fsanzeni/FSC-BT631D-Breakout/ADAU1701-DSP/ADAU1701-DSP.kicad_pcb

## KiCad design ADAU1701-DSP/ADAU1701-DSP.kicad_pcb (2025-05-22)

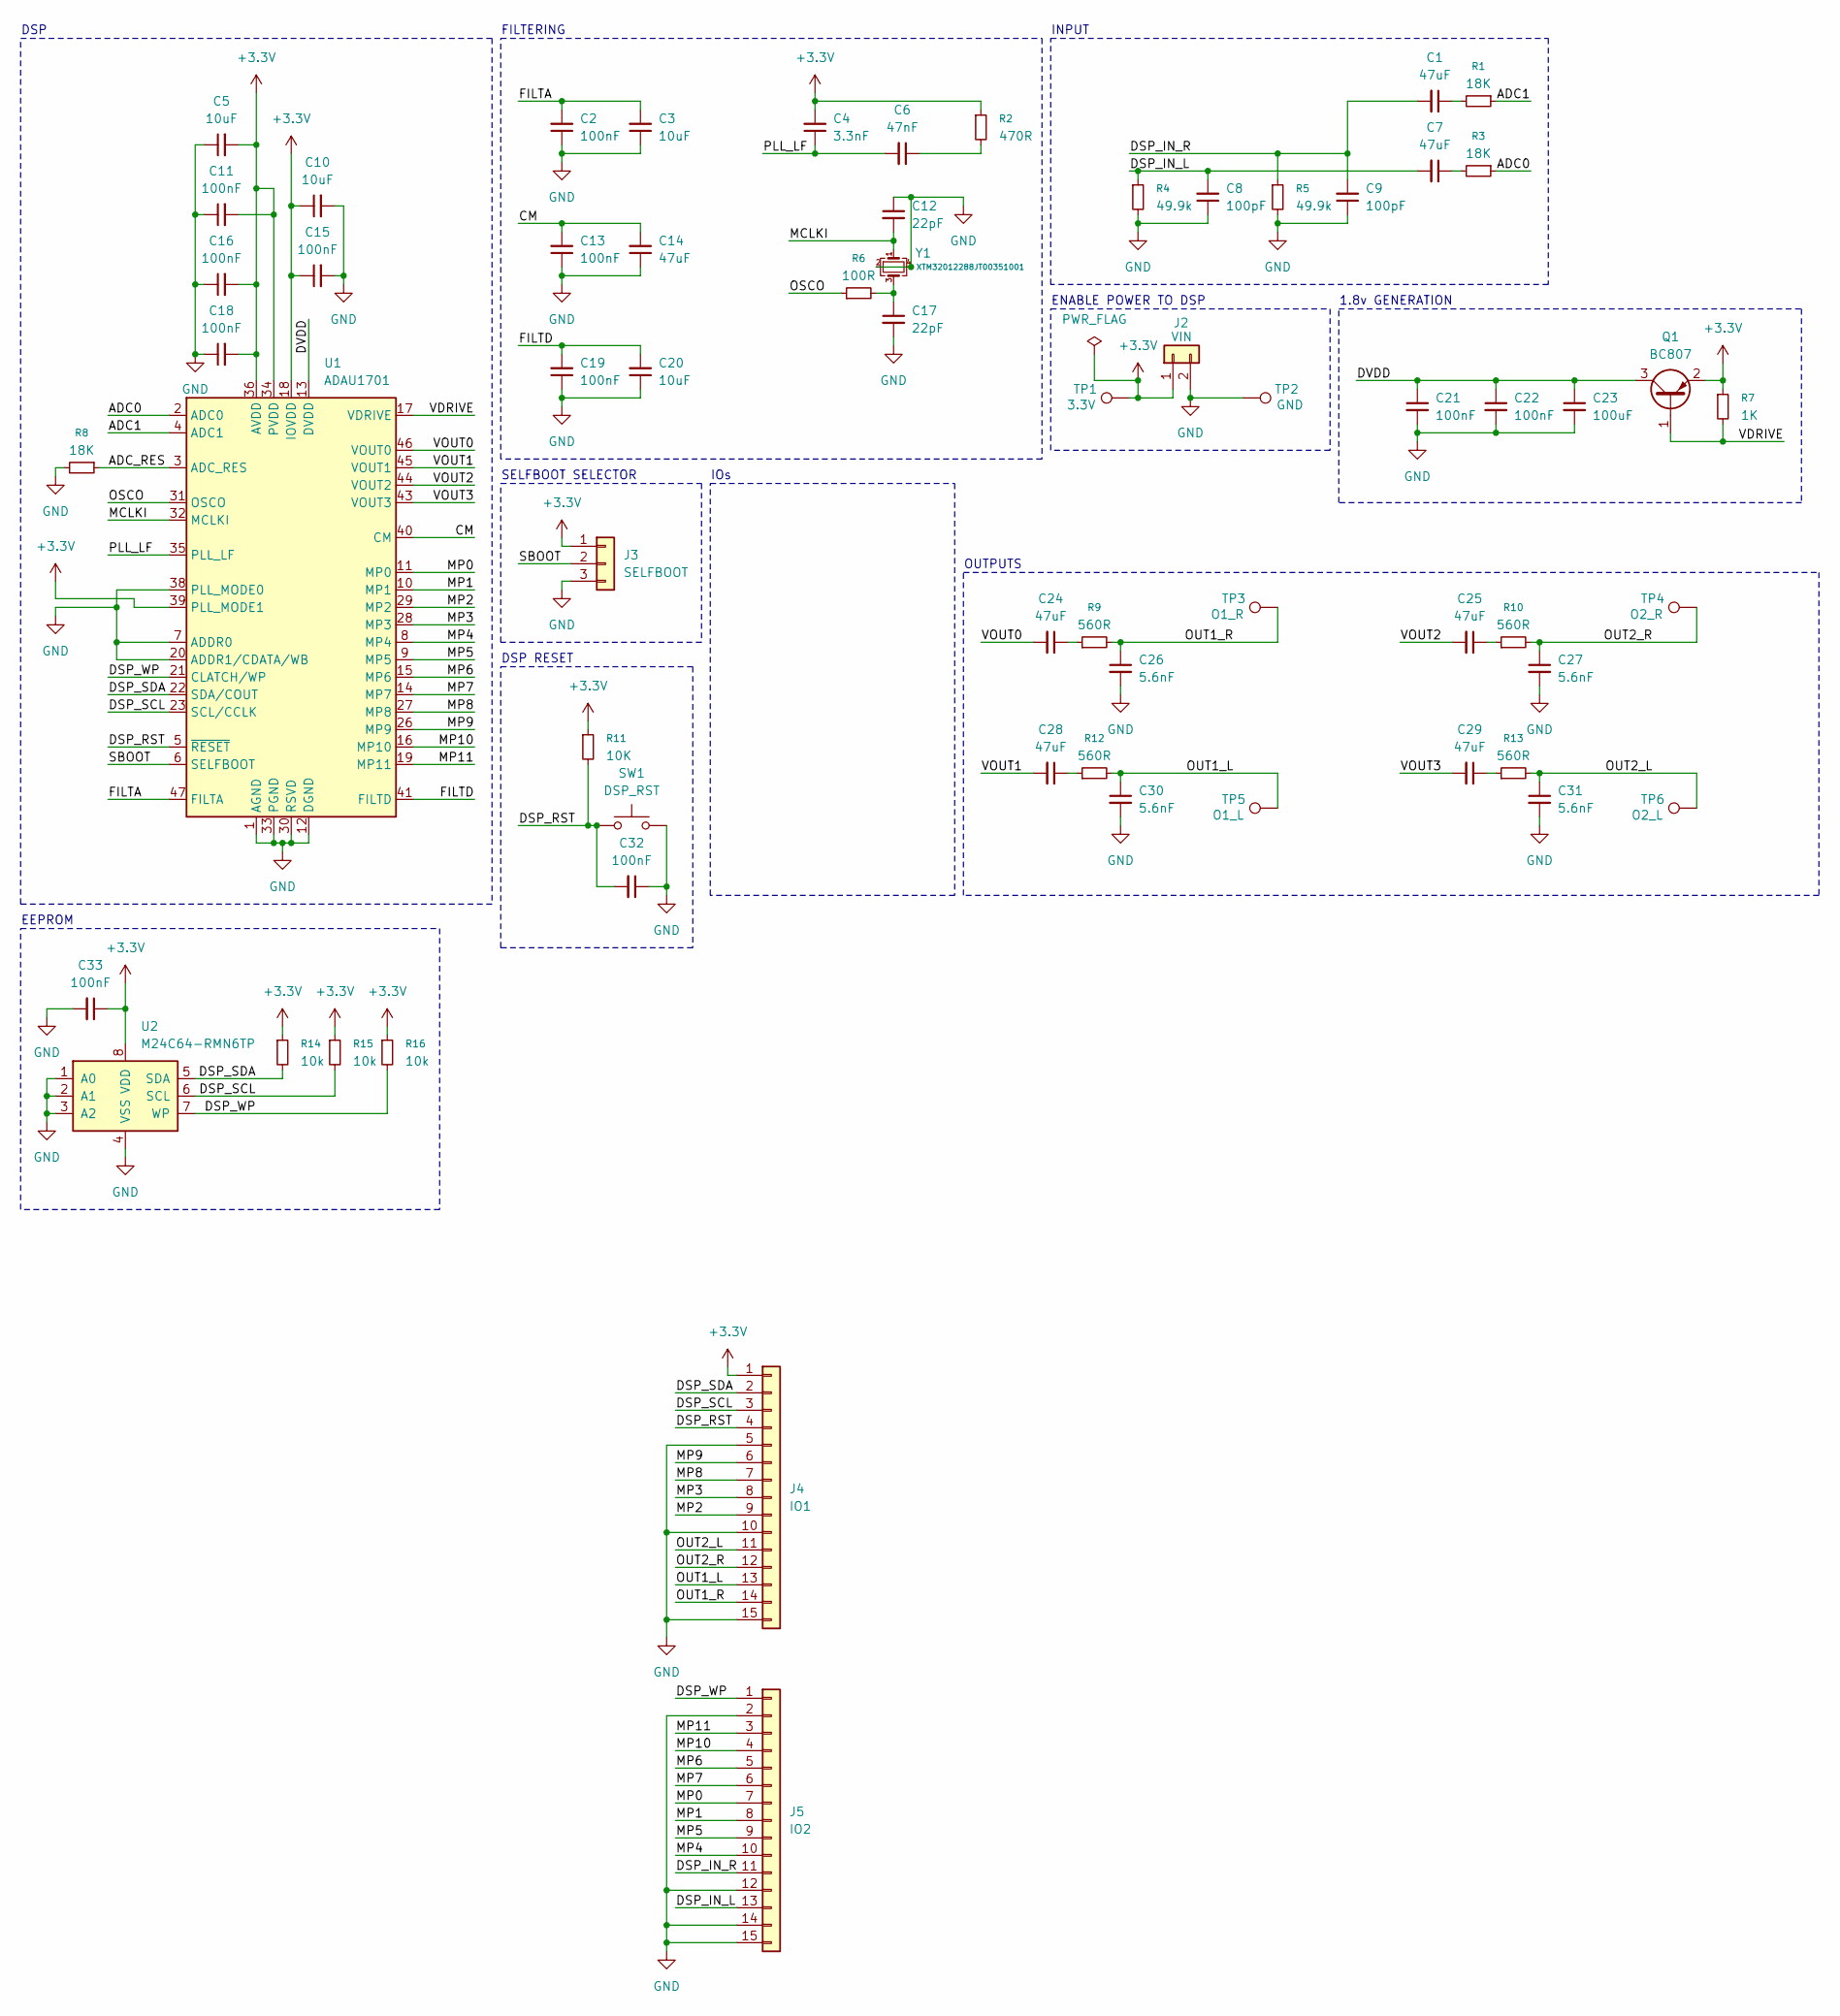
[picture p1: schematic ADAU1701-DSP.kicad_sch]

Parts:
C1, C7, C14, C24, C25, C28, C29: 47uF; C_0603_1608Metric_Pad1.08x0.95mm_HandSolder
C2, C11, C13, C15, C16, C18, C19, C21, C22, C32, C33: 100nF; C_0603_1608Metric_Pad1.08x0.95mm_HandSolder
C3, C5, C10, C20: 10uF; C_0603_1608Metric_Pad1.08x0.95mm_HandSolder
C4: 3.3nF; C_0603_1608Metric_Pad1.08x0.95mm_HandSolder
C6: 47nF; C_0603_1608Metric_Pad1.08x0.95mm_HandSolder
C8, C9: 100pF; C_0603_1608Metric_Pad1.08x0.95mm_HandSolder
C12, C17: 22pF; C_0603_1608Metric_Pad1.08x0.95mm_HandSolder
C23: 100uF; C_0603_1608Metric_Pad1.08x0.95mm_HandSolder
C26, C27, C30, C31: 5.6nF; C_0603_1608Metric_Pad1.08x0.95mm_HandSolder
J2: VIN; PinSocket_1x02_P2.54mm_Vertical
J3: SELFBOOT; PinHeader_1x03_P2.54mm_Vertical
J4: IO1; PinSocket_1x15_P2.54mm_Vertical
J5: IO2; PinSocket_1x15_P2.54mm_Vertical
Q1: BC807; SOT-23
R1, R3, R8: 18K; R_0603_1608Metric_Pad0.98x0.95mm_HandSolder
R2: 470R; R_0603_1608Metric_Pad0.98x0.95mm_HandSolder
R4, R5: 49.9k; R_0603_1608Metric_Pad0.98x0.95mm_HandSolder
R6: 100R; R_0603_1608Metric_Pad0.98x0.95mm_HandSolder
R7: 1K; R_0603_1608Metric_Pad0.98x0.95mm_HandSolder
R9, R10, R12, R13: 560R; R_0603_1608Metric_Pad0.98x0.95mm_HandSolder
R11: 10K; R_0603_1608Metric_Pad0.98x0.95mm_HandSolder
R14, R15, R16: 10k; R_0603_1608Metric_Pad0.98x0.95mm_HandSolder
SW1: DSP_RST; TS3425BA
TP1: 3.3V; TestPoint_THTPad_1.0x1.0mm_Drill0.5mm
TP2: GND; TestPoint_THTPad_1.0x1.0mm_Drill0.5mm
TP3: O1_R; TestPoint_THTPad_1.0x1.0mm_Drill0.5mm
TP4: O2_R; TestPoint_THTPad_1.0x1.0mm_Drill0.5mm
TP5: O1_L; TestPoint_THTPad_1.0x1.0mm_Drill0.5mm
TP6: O2_L; TestPoint_THTPad_1.0x1.0mm_Drill0.5mm
U1: ADAU1701; LQFP-48_7x7mm_P0.5mm
U2: M24C64-RMN6TP; SOIC-8_3.9x4.9mm_P1.27mm
Y1: XTM32012288JT00351001; Crystal_SMD_3225-4Pin_3.2x2.5mm_HandSoldering

Connections:
+3.3V: C4.2, C5.2, C10.1, C11.2, C15.1, C16.2, C18.2, C33.1, J2.1, J3.1, J4.1, Q1.2 (E), R2.1, R7.1, R11.1, R14.1, R15.1, R16.1, TP1.1, U1.18 (IOVDD), U1.34 (PVDD), U1.36 (AVDD), U1.39 (PLL_MODE1), U1.48 (AVDD), U2.8 (VDD)
/ADC0: R3.1, U1.2 (ADC0)
/ADC1: R1.1, U1.4 (ADC1)
/ADC_RES: R8.1, U1.3 (ADC_RES)
/CM: C13.2, C14.2, U1.40 (CM)
/DSP_IN_L: C7.2, C8.2, J5.13, R4.1
/DSP_IN_R: C1.2, C9.2, J5.11, R5.1
/DSP_RST: C32.2, J4.4, R11.2, SW1.1, U1.5 (~RESET)
/DSP_SCL: J4.3, R15.2, U1.23 (SCL/CCLK), U2.6 (SCL)
/DSP_SDA: J4.2, R14.2, U1.22 (SDA/COUT), U2.5 (SDA)
/DSP_WP: J5.1, R16.2, U1.21 (CLATCH/WP), U2.7 (WP)
/DVDD: C21.1, C22.1, C23.1, Q1.3 (C), U1.13 (DVDD), U1.24 (DVDD)
/FILTA: C2.2, C3.2, U1.47 (FILTA)
/FILTD: C19.2, C20.2, U1.41 (FILTD)
/MCLKI: C12.2, U1.32 (MCLKI), Y1.1
/MP0: J5.7, U1.11 (MP0)
/MP1: J5.8, U1.10 (MP1)
/MP2: J4.9, U1.29 (MP2)
/MP3: J4.8, U1.28 (MP3)
/MP4: J5.10, U1.8 (MP4)
/MP5: J5.9, U1.9 (MP5)
/MP6: J5.5, U1.15 (MP6)
/MP7: J5.6, U1.14 (MP7)
/MP8: J4.7, U1.27 (MP8)
/MP9: J4.6, U1.26 (MP9)
/MP10: J5.4, U1.16 (MP10)
/MP11: J5.3, U1.19 (MP11)
/OSCO: R6.1, U1.31 (OSCO)
/OUT1_L: C30.1, J4.13, R12.2, TP5.1
/OUT1_R: C26.1, J4.14, R9.2, TP3.1
/OUT2_L: C31.1, J4.11, R13.2, TP6.1
/OUT2_R: C27.1, J4.12, R10.2, TP4.1
/PLL_LF: C4.1, C6.2, U1.35 (PLL_LF)
/SBOOT: J3.2, U1.6 (SELFBOOT)
/VDRIVE: Q1.1 (B), R7.2, U1.17 (VDRIVE)
/VOUT0: C24.2, U1.46 (VOUT0)
/VOUT1: C28.2, U1.45 (VOUT1)
/VOUT2: C25.2, U1.44 (VOUT2)
/VOUT3: C29.2, U1.43 (VOUT3)
GND: C2.1, C3.1, C5.1, C8.1, C9.1, C10.2, C11.1, C12.1, C13.1, C14.1, C15.2, C16.1, C17.2, C18.1, C19.1, C20.1, C21.2, C22.2, C23.2, C26.2, C27.2, C30.2, C31.2, C32.1, C33.2, J2.2, J3.3, J4.5, J4.10, J4.15, J5.2, J5.12, J5.14, J5.15, R4.2, R5.2, R8.2, SW1.2, TP2.1, U1.1 (AGND), U1.7 (ADDR0), U1.12 (DGND), U1.20 (ADDR1/CDATA/WB), U1.25 (DGND), U1.30 (RSVD), U1.33 (PGND), U1.37 (AGND), U1.38 (PLL_MODE0), U1.42 (AGND), U2.1 (A0), U2.2 (A1), U2.3 (A2), U2.4 (VSS), Y1.2, Y1.4
unnamed: C1.1, R1.2
unnamed: C6.1, R2.2
unnamed: C7.1, R3.2
unnamed: C17.1, R6.2, Y1.3
unnamed: C24.1, R9.1
unnamed: C25.1, R10.1
unnamed: C28.1, R12.1
unnamed: C29.1, R13.1

Notes on the sheet:
EEPROM
INPUT
DSP RESET
FILTERING
DSP
IOs
SELFBOOT SELECTOR
ENABLE POWER TO DSP
1.8v GENERATION
OUTPUTS

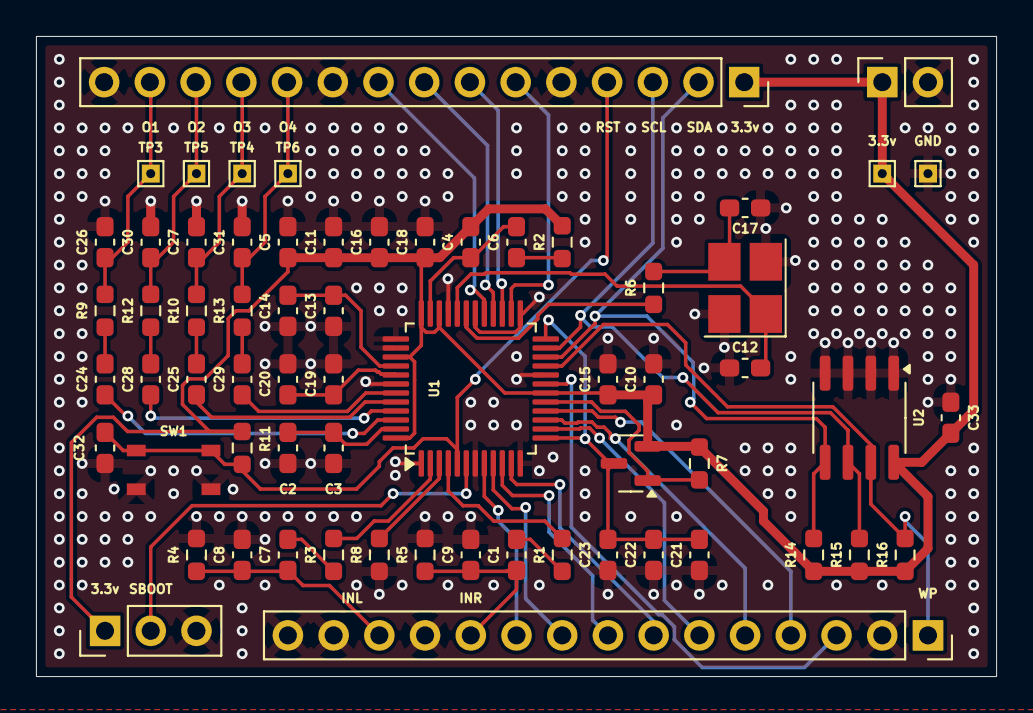
[picture p2: board ADAU1701-DSP.kicad_pcb from above]

Board: 2 copper layers, 53.3 x 35.6 mm, 64 parts (0 on the bottom side), 48 nets.
