fsanzeni/FSC-BT631D-Breakout/FSC-BT631D-Breakout/FSC-BT631D-Breakout.kicad_pcb

## KiCad design FSC-BT631D-Breakout/FSC-BT631D-Breakout.kicad_pcb (2025-05-21)

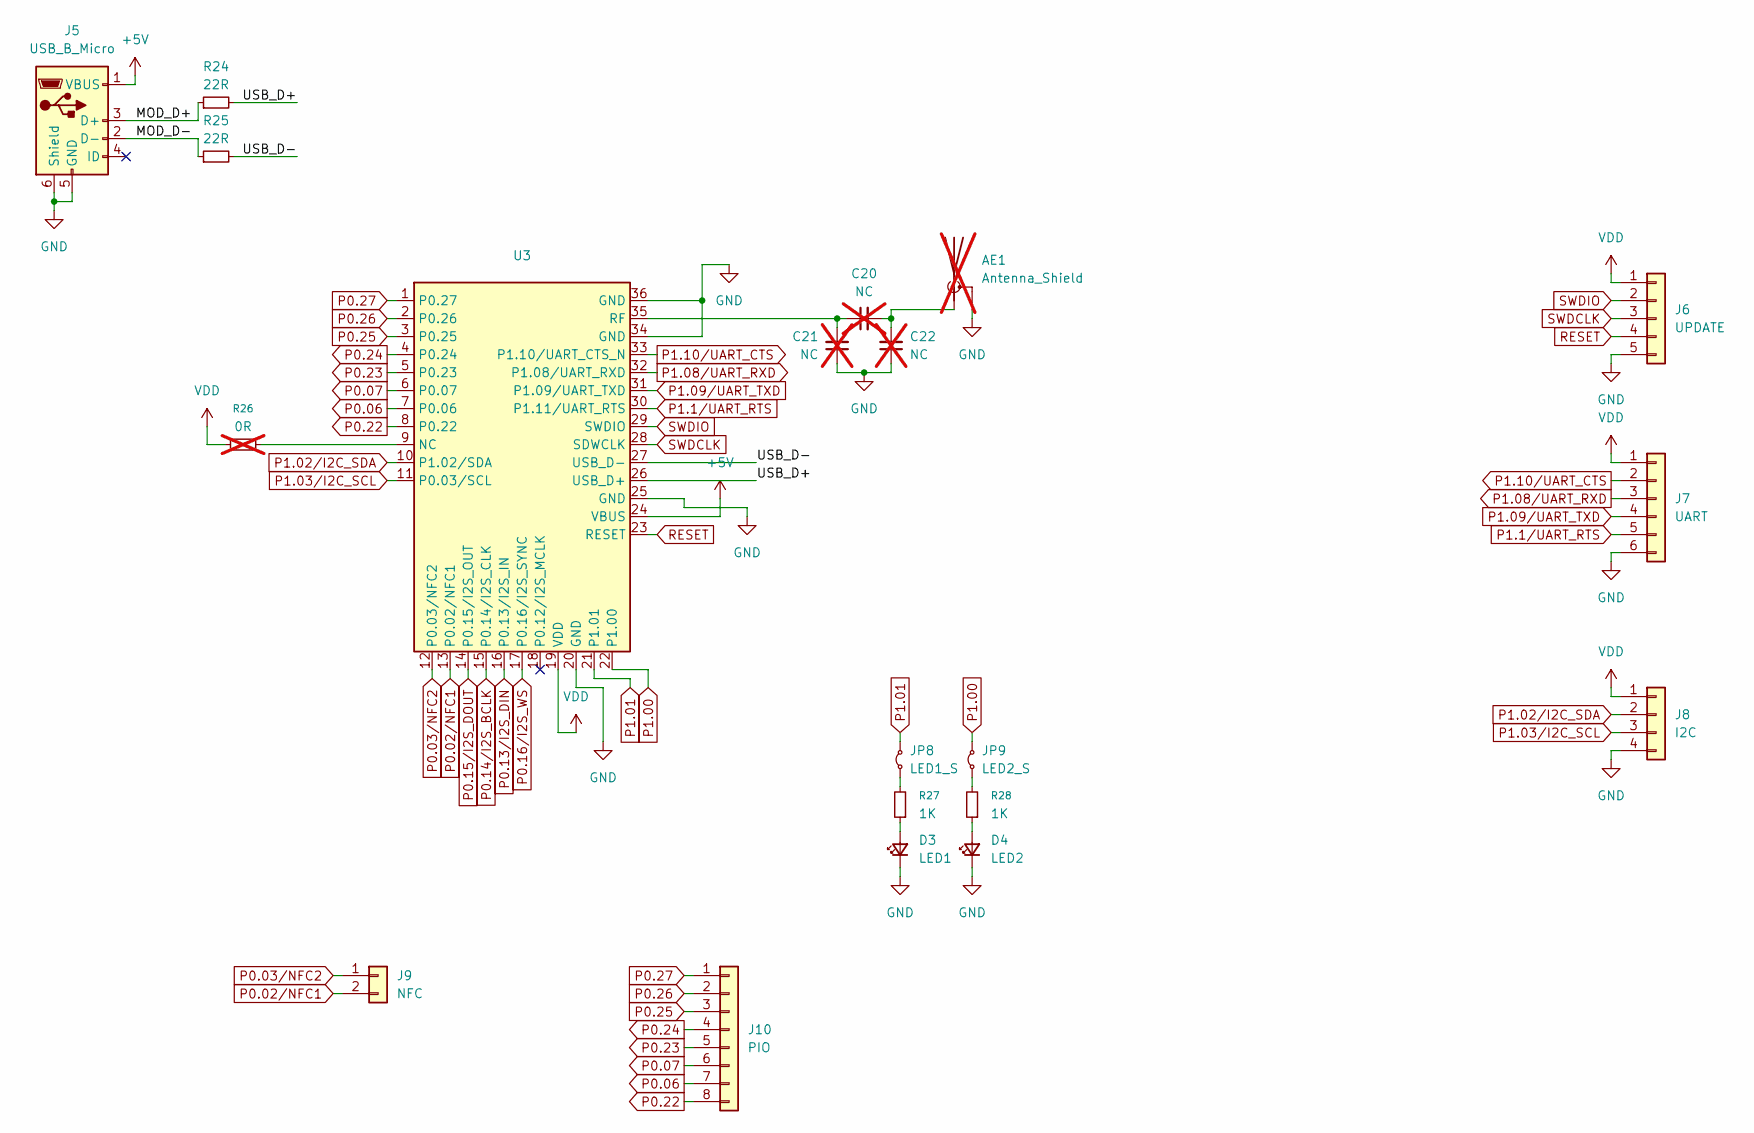
[picture p3: schematic module.kicad_sch]

Parts:
AE1: Antenna_Shield; U.FL_Hirose_U.FL-R-SMT-1_Vertical; not fitted
C20, C21, C22: NC; C_0603_1608Metric_Pad1.08x0.95mm_HandSolder; not fitted
D3: LED1; LED_0603_1608Metric_Pad1.05x0.95mm_HandSolder
D4: LED2; LED_0603_1608Metric_Pad1.05x0.95mm_HandSolder
J5: USB_B_Micro; KH-MICRO5P-JN
J6: UPDATE; PinSocket_1x05_P2.54mm_Vertical
J7: UART; PinSocket_1x06_P2.54mm_Vertical
J8: I2C; PinSocket_1x04_P2.54mm_Vertical
J9: NFC; PinSocket_1x02_P2.54mm_Vertical
J10: PIO; PinSocket_1x08_P2.54mm_Vertical
JP8: LED1_S; SolderJumper-2_P1.3mm_Bridged2Bar_RoundedPad1.0x1.5mm
JP9: LED2_S; SolderJumper-2_P1.3mm_Bridged2Bar_RoundedPad1.0x1.5mm
R24, R25: 22R; R_0603_1608Metric_Pad0.98x0.95mm_HandSolder
R26: 0R; R_0603_1608Metric_Pad0.98x0.95mm_HandSolder; not fitted
R27, R28: 1K; R_0603_1608Metric_Pad0.98x0.95mm_HandSolder
U3: FSC-BT631D

Connections:
+5V: J5.1 (VBUS), U3.24 (VBUS)
/module/MOD_D+: J5.3 (D+), R24.1
/module/MOD_D-: J5.2 (D-), R25.1
/module/USB_D+: R24.2, U3.26 (USB_D+)
/module/USB_D-: R25.2, U3.27 (USB_D-)
GND: AE1.2 (Shield), C21.1, C22.1, D3.1 (K), D4.1 (K), J5.5 (GND), J5.6 (Shield), J6.5, J7.6, J8.4, U3.20 (GND), U3.25 (GND), U3.34 (GND), U3.36 (GND); also elsewhere on the board
unnamed: AE1.1 (A), C20.2, C22.2
unnamed: D3.2 (A), R27.1
unnamed: D4.2 (A), R28.1
unnamed: JP8.1 (A), R27.2
unnamed: JP9.1 (A), R28.2
unnamed: R26.2, U3.9 (NC)
unnamed: C20.1, C21.2, U3.35 (RF)
P0.02/NFC1: J9.2, U3.13 (P0.02/NFC1)
P0.03/NFC2: J9.1, U3.12 (P0.03/NFC2)
P0.06: J10.7, U3.7 (P0.06)
P0.07: J10.6, U3.6 (P0.07)
P0.13/I2S_DIN: U3.16 (P0.13/I2S_IN); also elsewhere on the board
P0.14/I2S_BCLK: U3.15 (P0.14/I2S_CLK); also elsewhere on the board
P0.15/I2S_DOUT: U3.14 (P0.15/I2S_OUT); also elsewhere on the board
P0.16/I2S_WS: U3.17 (P0.16/I2S_SYNC); also elsewhere on the board
P0.22: J10.8, U3.8 (P0.22)
P0.23: J10.5, U3.5 (P0.23)
P0.24: J10.4, U3.4 (P0.24)
P0.25: J10.3, U3.3 (P0.25)
P0.26: J10.2, U3.2 (P0.26)
P0.27: J10.1, U3.1 (P0.27)
P1.00: JP9.2 (B), U3.22 (P1.00)
P1.01: JP8.2 (B), U3.21 (P1.01)
P1.1/UART_RTS: J7.5, U3.30 (P1.11/UART_RTS)
P1.02/I2C_SDA: J8.2, U3.10 (P1.02/SDA); also elsewhere on the board
P1.03/I2C_SCL: J8.3, U3.11 (P0.03/SCL); also elsewhere on the board
P1.08/UART_RXD: J7.3, U3.32 (P1.08/UART_RXD)
P1.09/UART_TXD: J7.4, U3.31 (P1.09/UART_TXD)
P1.10/UART_CTS: J7.2, U3.33 (P1.10/UART_CTS_N)
RESET: J6.4, U3.23 (RESET)
SWDCLK: J6.3, U3.28 (SDWCLK)
SWDIO: J6.2, U3.29 (SWDIO)
VDD: J6.1, J7.1, J8.1, R26.1, U3.19 (VDD); also elsewhere on the board

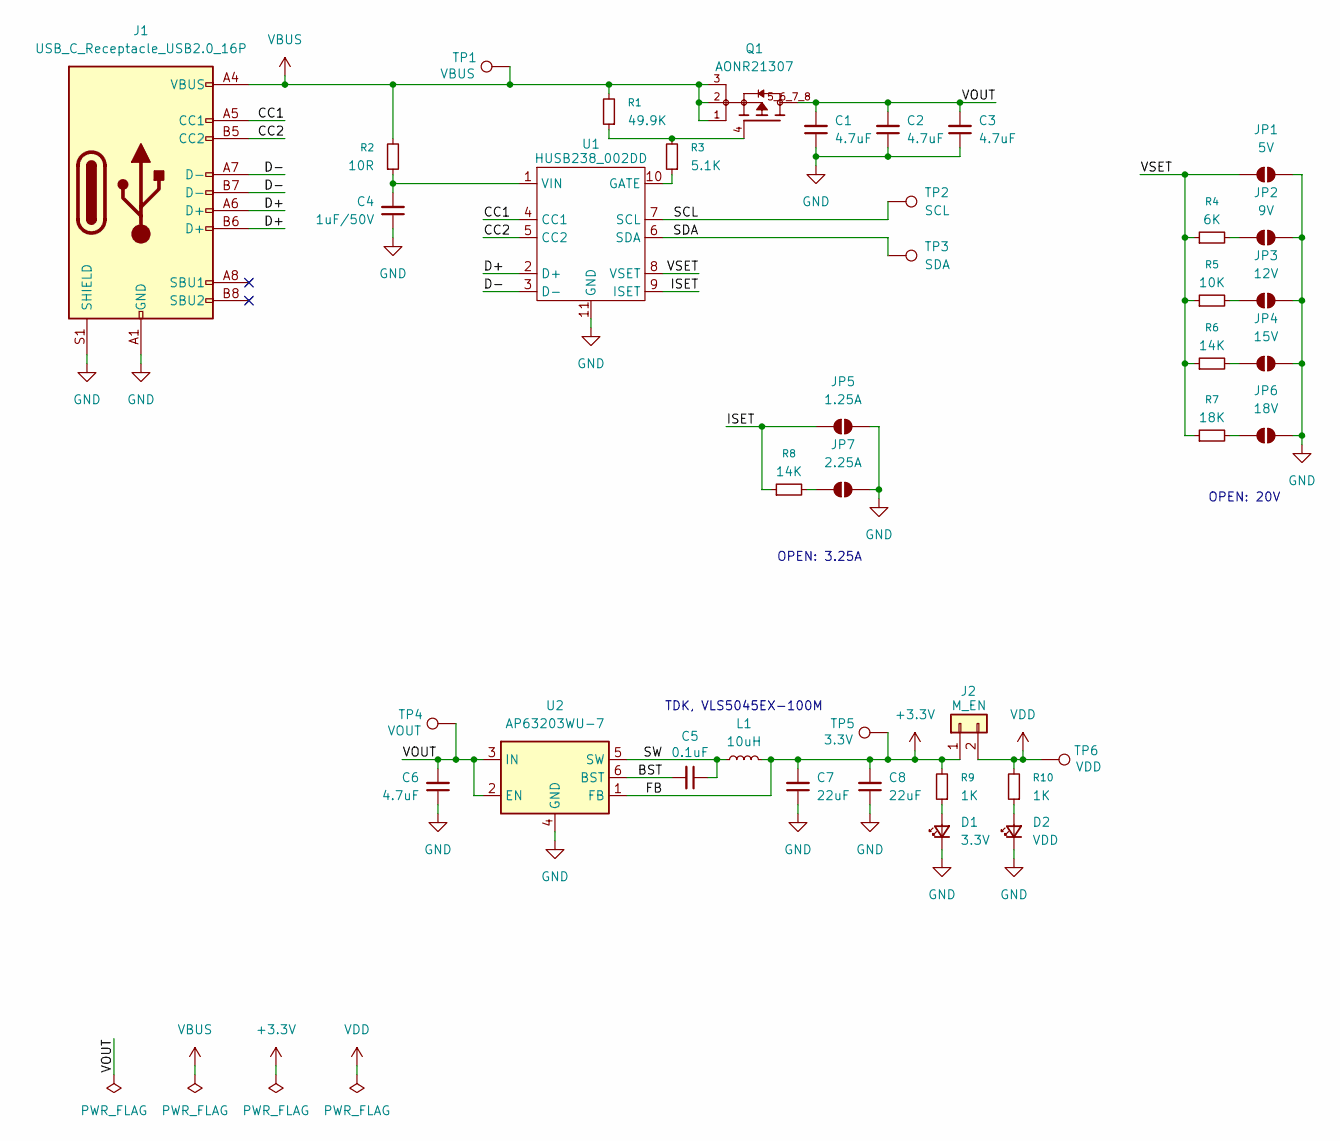
[picture p4: schematic power.kicad_sch]

Parts:
C1, C2, C3, C6: 4.7uF; C_0603_1608Metric_Pad1.08x0.95mm_HandSolder
C4: 1uF/50V; C_0603_1608Metric_Pad1.08x0.95mm_HandSolder
C5: 0.1uF; C_0603_1608Metric_Pad1.08x0.95mm_HandSolder
C7, C8: 22uF; C_0603_1608Metric_Pad1.08x0.95mm_HandSolder
D1: 3.3V; LED_0603_1608Metric_Pad1.05x0.95mm_HandSolder
D2: VDD; LED_0603_1608Metric_Pad1.05x0.95mm_HandSolder
J1: USB_C_Receptacle_USB2.0_16P; SHOUHAN_TYPE-C_16PIN_2MD__073
J2: M_EN; PinSocket_1x02_P2.54mm_Vertical
JP1: 5V; SolderJumper-2_P1.3mm_Open_RoundedPad1.0x1.5mm
JP2: 9V; SolderJumper-2_P1.3mm_Open_RoundedPad1.0x1.5mm
JP3: 12V; SolderJumper-2_P1.3mm_Open_RoundedPad1.0x1.5mm
JP4: 15V; SolderJumper-2_P1.3mm_Open_RoundedPad1.0x1.5mm
JP5: 1.25A; SolderJumper-2_P1.3mm_Open_RoundedPad1.0x1.5mm
JP6: 18V; SolderJumper-2_P1.3mm_Open_RoundedPad1.0x1.5mm
JP7: 2.25A; SolderJumper-2_P1.3mm_Open_RoundedPad1.0x1.5mm
L1: 10uH; VLS5045EX330M
Q1: AONR21307; PARTREV 1.1
R1: 49.9K; R_0603_1608Metric_Pad0.98x0.95mm_HandSolder
R2: 10R; R_0603_1608Metric_Pad0.98x0.95mm_HandSolder
R3: 5.1K; R_0603_1608Metric_Pad0.98x0.95mm_HandSolder
R4: 6K; R_0603_1608Metric_Pad0.98x0.95mm_HandSolder
R5: 10K; R_0603_1608Metric_Pad0.98x0.95mm_HandSolder
R6, R8: 14K; R_0603_1608Metric_Pad0.98x0.95mm_HandSolder
R7: 18K; R_0603_1608Metric_Pad0.98x0.95mm_HandSolder
R9, R10: 1K; R_0603_1608Metric_Pad0.98x0.95mm_HandSolder
TP1: VBUS; TestPoint_THTPad_1.0x1.0mm_Drill0.5mm
TP2: SCL; TestPoint_Pad_D1.5mm
TP3: SDA; TestPoint_Pad_D1.5mm
TP4: VOUT; TestPoint_THTPad_1.0x1.0mm_Drill0.5mm
TP5: 3.3V; TestPoint_THTPad_1.0x1.0mm_Drill0.5mm
TP6: VDD; TestPoint_THTPad_1.0x1.0mm_Drill0.5mm
U1: HUSB238_002DD; DFN-10-1EP_3x3mm_P0.5mm_EP1.65x2.38mm_ThermalVias
U2: AP63203WU-7; TSOT-23-6

Connections:
+3.3V: C7.2, C8.2, J2.1, L1.2, R9.2, TP5.1, U2.1 (FB); also elsewhere on the board
/power/BST: C5.2, U2.6 (BST)
/power/CC1: J1.A5 (CC1), U1.4 (CC1)
/power/CC2: J1.B5 (CC2), U1.5 (CC2)
/power/D+: J1.A6 (D+), J1.B6 (D+), U1.2 (D+)
/power/D-: J1.A7 (D-), J1.B7 (D-), U1.3 (D-)
/power/ISET: JP5.1 (A), R8.1, U1.9 (ISET)
/power/SCL: TP2.1, U1.7 (SCL)
/power/SDA: TP3.1, U1.6 (SDA)
/power/SW: C5.1, L1.1, U2.5 (SW)
/power/VOUT: C1.2, C2.2, C3.2, C6.2, Q1.5_6_7_8, TP4.1, U2.2 (EN), U2.3 (IN)
/power/VSET: JP1.1 (A), R4.1, R5.1, R6.1, R7.1, U1.8 (VSET)
GND: C1.1, C2.1, C3.1, C4.1, C6.1, C7.1, C8.1, D1.1 (K), D2.1 (K), J1.A1 (GND), J1.A12 (GND), J1.B1 (GND), J1.B12 (GND), J1.S1 (SHIELD), JP1.2 (B), JP2.2 (B), JP3.2 (B), JP4.2 (B), JP5.2 (B), JP6.2 (B), JP7.2 (B), U1.11 (GND), U2.4 (GND); also elsewhere on the board
unnamed: D1.2 (A), R9.1
unnamed: D2.2 (A), R10.1
unnamed: JP2.1 (A), R4.2
unnamed: JP3.1 (A), R5.2
unnamed: JP4.1 (A), R6.2
unnamed: JP6.1 (A), R7.2
unnamed: JP7.1 (A), R8.2
unnamed: Q1.4, R1.1, R3.2
unnamed: R3.1, U1.10 (GATE)
unnamed: C4.2, R2.1, U1.1 (VIN)
VBUS: J1.A4 (VBUS), J1.A9 (VBUS), J1.B4 (VBUS), J1.B9 (VBUS), Q1.1, Q1.2, Q1.3, R1.2, R2.2, TP1.1
VDD: J2.2, R10.2, TP6.1; also elsewhere on the board

Notes on the sheet:
OPEN: 20V
TDK, VLS5045EX-100M
OPEN: 3.25A

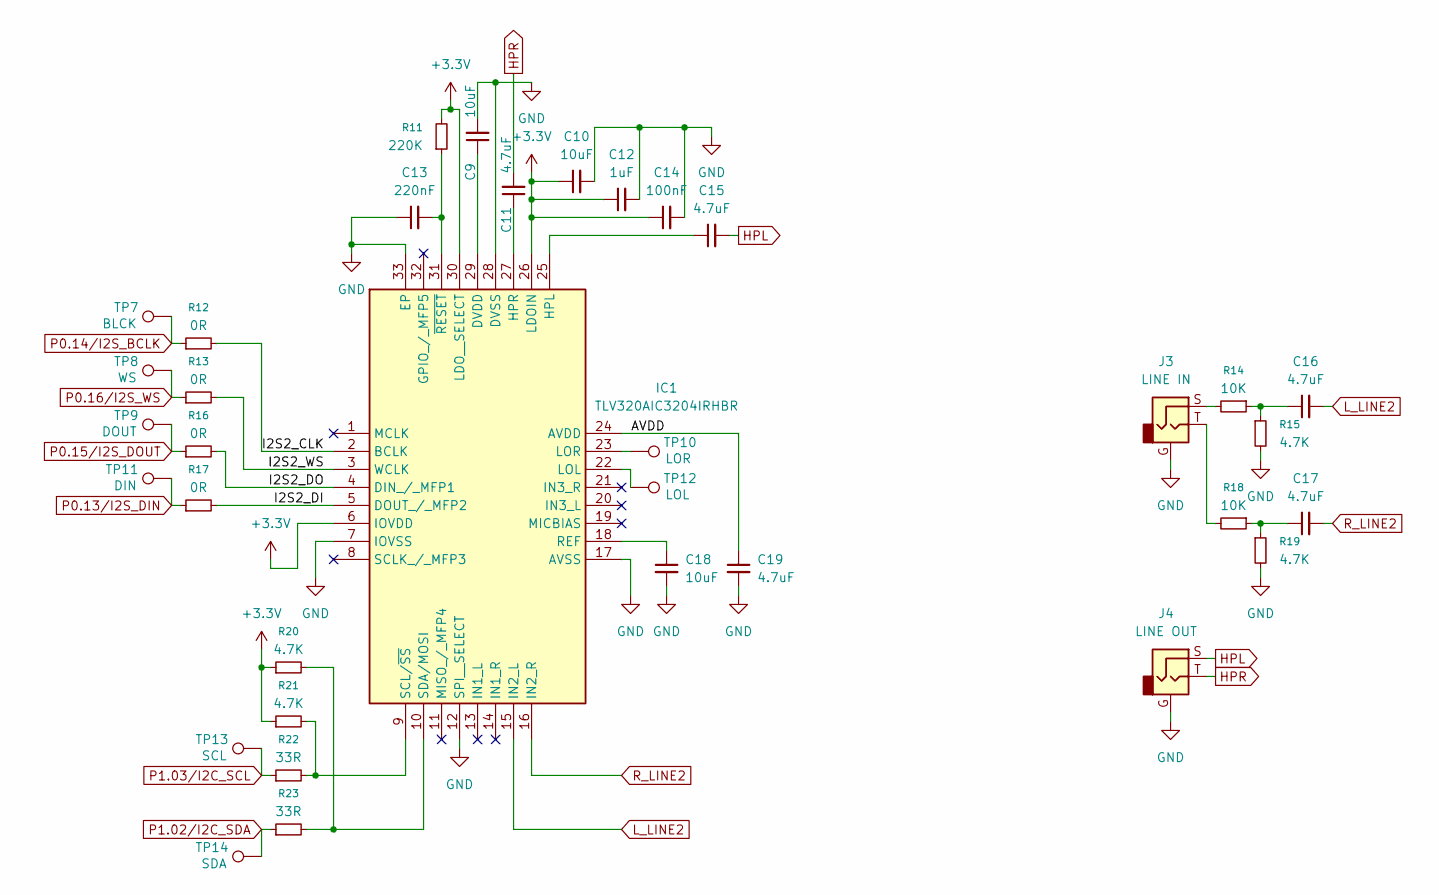
[picture p5: schematic codec.kicad_sch]

Parts:
C9, C10, C18: 10uF; C_0603_1608Metric_Pad1.08x0.95mm_HandSolder
C11, C15, C16, C17, C19: 4.7uF; C_0603_1608Metric_Pad1.08x0.95mm_HandSolder
C12: 1uF; C_0603_1608Metric_Pad1.08x0.95mm_HandSolder
C13: 220nF; C_0603_1608Metric_Pad1.08x0.95mm_HandSolder
C14: 100nF; C_0603_1608Metric_Pad1.08x0.95mm_HandSolder
IC1: TLV320AIC3204IRHBR; QFN50P500X500X100-33N-D; Mouser Part Number 595-V320AIC3204IRHBR
J3: LINE IN; XKB_PJ-3200
J4: LINE OUT; XKB_PJ-3200
R11: 220K; R_0603_1608Metric_Pad0.98x0.95mm_HandSolder
R12, R13, R16, R17: 0R; R_0603_1608Metric_Pad0.98x0.95mm_HandSolder
R14, R18: 10K; R_0603_1608Metric_Pad0.98x0.95mm_HandSolder
R15, R19, R20, R21: 4.7K; R_0603_1608Metric_Pad0.98x0.95mm_HandSolder
R22, R23: 33R; R_0603_1608Metric_Pad0.98x0.95mm_HandSolder
TP7: BLCK; TestPoint_THTPad_1.0x1.0mm_Drill0.5mm
TP8: WS; TestPoint_THTPad_1.0x1.0mm_Drill0.5mm
TP9: DOUT; TestPoint_THTPad_1.0x1.0mm_Drill0.5mm
TP10: LOR; TestPoint_THTPad_1.0x1.0mm_Drill0.5mm
TP11: DIN; TestPoint_THTPad_1.0x1.0mm_Drill0.5mm
TP12: LOL; TestPoint_THTPad_1.0x1.0mm_Drill0.5mm
TP13: SCL; TestPoint_THTPad_1.0x1.0mm_Drill0.5mm
TP14: SDA; TestPoint_THTPad_1.0x1.0mm_Drill0.5mm

Connections:
+3.3V: C10.1, C12.1, C14.1, IC1.6 (IOVDD), IC1.26 (LDOIN), IC1.30 (LDO__SELECT), R11.2, R20.1, R21.1; also elsewhere on the board
/codec/AVDD: C19.1, IC1.24 (AVDD)
/codec/I2S2_CLK: IC1.2 (BCLK), R12.2
/codec/I2S2_DI: IC1.5 (DOUT_/_MFP2), R17.2
/codec/I2S2_DO: IC1.4 (DIN_/_MFP1), R16.2
/codec/I2S2_WS: IC1.3 (WCLK), R13.2
GND: C9.2, C10.2, C12.2, C13.1, C14.2, C18.2, C19.2, IC1.7 (IOVSS), IC1.12 (SPI__SELECT), IC1.17 (AVSS), IC1.28 (DVSS), IC1.33 (EP), J3.G, J4.G, R15.2, R19.2; also elsewhere on the board
HPL: C15.2, J4.S
HPR: C11.2, J4.T
L_LINE2: C16.2, IC1.15 (IN2_L)
unnamed: C16.1, R14.1, R15.1
unnamed: C17.1, R18.1, R19.1
unnamed: C9.1, IC1.29 (DVDD)
unnamed: C15.1, IC1.25 (HPL)
unnamed: C11.1, IC1.27 (HPR)
unnamed: IC1.22 (LOL), TP12.1
unnamed: IC1.23 (LOR), TP10.1
unnamed: C18.1, IC1.18 (REF)
unnamed: IC1.9 (SCL/~SS), R21.2, R22.2
unnamed: IC1.10 (SDA/MOSI), R20.2, R23.2
unnamed: C13.2, IC1.31 (~RESET), R11.1
unnamed: J3.S, R14.2
unnamed: J3.T, R18.2
P0.13/I2S_DIN: R17.1, TP11.1; also elsewhere on the board
P0.14/I2S_BCLK: R12.1, TP7.1; also elsewhere on the board
P0.15/I2S_DOUT: R16.1, TP9.1; also elsewhere on the board
P0.16/I2S_WS: R13.1, TP8.1; also elsewhere on the board
P1.02/I2C_SDA: R23.1, TP14.1; also elsewhere on the board
P1.03/I2C_SCL: R22.1, TP13.1; also elsewhere on the board
R_LINE2: C17.2, IC1.16 (IN2_R)

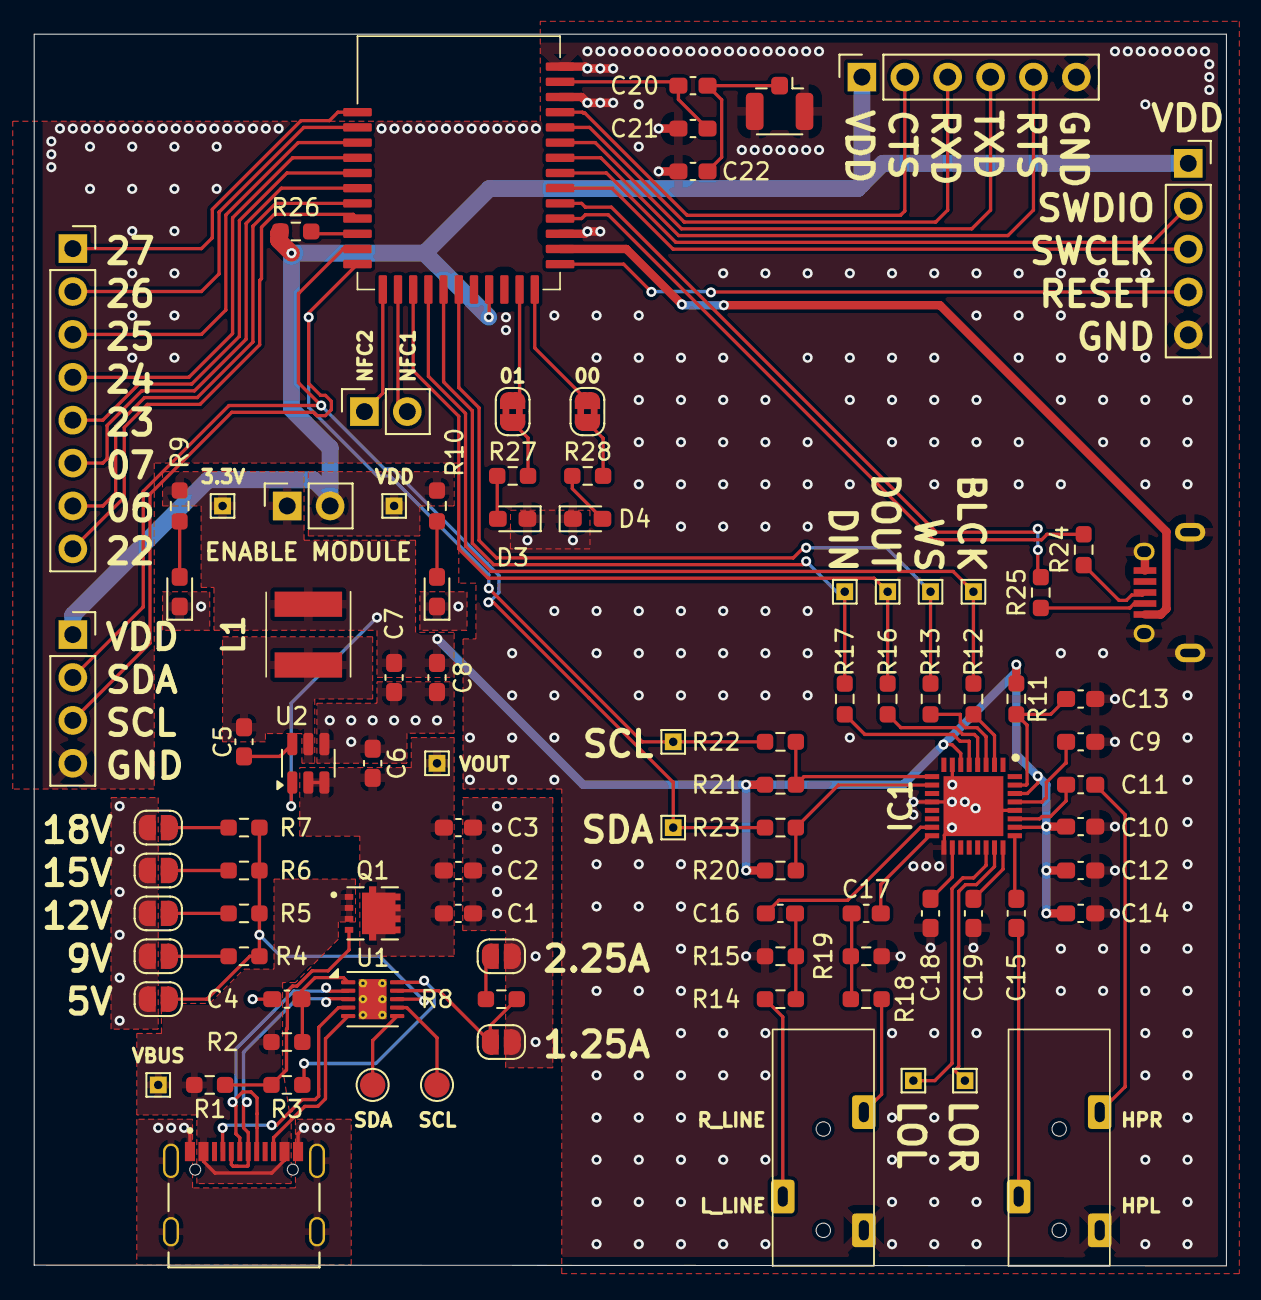
[picture p6: board FSC-BT631D-Breakout.kicad_pcb from above]

Board: 2 copper layers, 70.6 x 72.9 mm, 94 parts (0 on the bottom side), 84 nets.
