fsanzeni/FSC-BT631D-Breakout/(commit log)

2025-04-30 added power schematic, gitignore
    [FSC-BT631D-Breakout.kicad_pcb, power.kicad_sch]
2025-04-30 power section done
    [FSC-BT631D-Breakout.kicad_pcb, power.kicad_sch]
2025-05-12 schematic completed
    [FSC-BT631D-Breakout.kicad_pcb, codec.kicad_sch, module.kicad_sch, power.kicad_sch]
2025-05-18 FINALISED LAYOUT
    [FSC-BT631D-Breakout.kicad_pcb, codec.kicad_sch, module.kicad_sch, power.kicad_sch]
2025-05-18 fixed silkscreen
    [FSC-BT631D-Breakout.kicad_pcb]
2025-05-20 fixed ground pour
    [FSC-BT631D-Breakout.kicad_pcb, FSC-BT631D-Breakout.kicad_sch, power.kicad_sch]
2025-05-21 added ibom & fabrication files
    [FSC-BT631D-Breakout-B_Cu.gbr, FSC-BT631D-Breakout-B_Mask.gbr, FSC-BT631D-Breakout-B_Paste.gbr, FSC-BT631D-Breakout-B_Silkscreen.gbr, FSC-BT631D-Breakout-Edge_Cuts.gbr, FSC-BT631D-Breakout-F_Cu.gbr, FSC-BT631D-Breakout-F_Mask.gbr, FSC-BT631D-Breakout-F_Paste.gbr]
2025-05-21 added dsp schematic
    [FSC-BT631D-Breakout.kicad_sch, dsp.kicad_sch, module.kicad_sch]
2025-05-21 initial routing
    [FSC-BT631D-Breakout.kicad_pcb, dsp.kicad_sch]
2025-05-21 folder restructure
    [ADAU1701-DSP.kicad_pcb, ADAU1701-DSP.kicad_sch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]
2025-05-22 dsp routing finished
    [ADAU1701-DSP-B_Cu.gbr, ADAU1701-DSP-B_Mask.gbr, ADAU1701-DSP-B_Paste.gbr, ADAU1701-DSP-B_Silkscreen.gbr, ADAU1701-DSP-Edge_Cuts.gbr, ADAU1701-DSP-F_Cu.gbr, ADAU1701-DSP-F_Mask.gbr, ADAU1701-DSP-F_Paste.gbr]
